davemuscle/camera_journey/doc/calling_the_gen.png

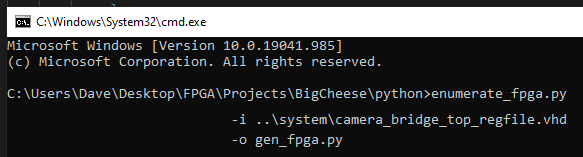
doc/calling_the_gen.png
