davemuscle/camera_journey/doc/CameraJourneyFront.jpg

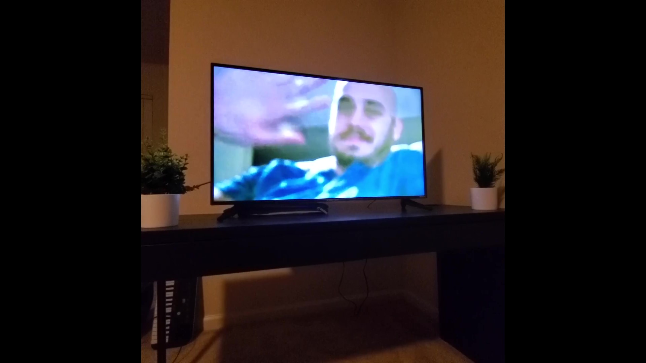
doc/CameraJourneyFront.jpg
