davemuscle/camera_journey/doc/device_tree.png

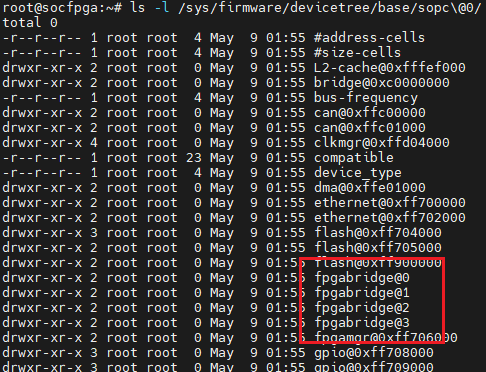
doc/device_tree.png
