davemuscle/camera_journey/doc/putty_boot.png

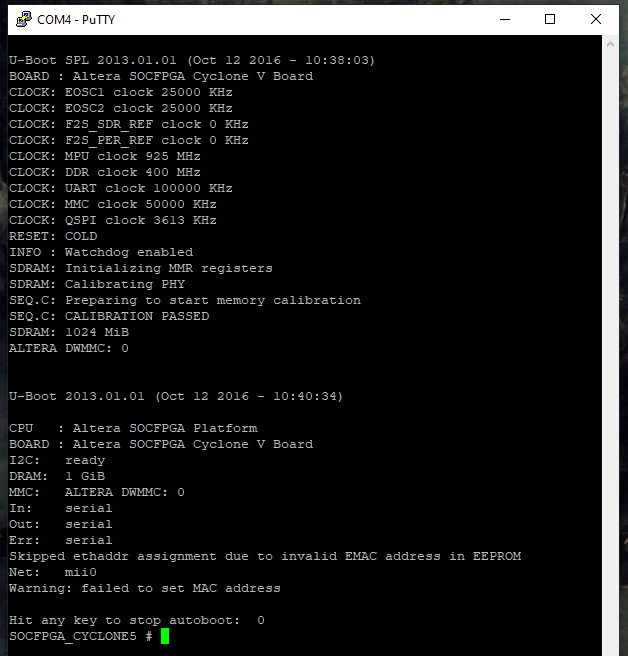
doc/putty_boot.png
