davemuscle/camera_journey/matlab/Font/CourierNew36_FontMap_MonoChrome.bmp

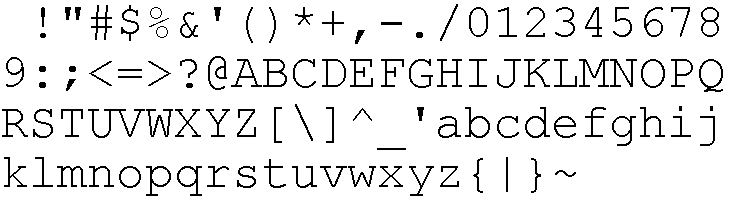
matlab/Font/CourierNew36_FontMap_MonoChrome.bmp
