davemuscle/camera_journey/kicad/DualCameraPlugIn.kicad_pcb

## KiCad design kicad/DualCameraPlugIn.kicad_pcb (2022-02-21)

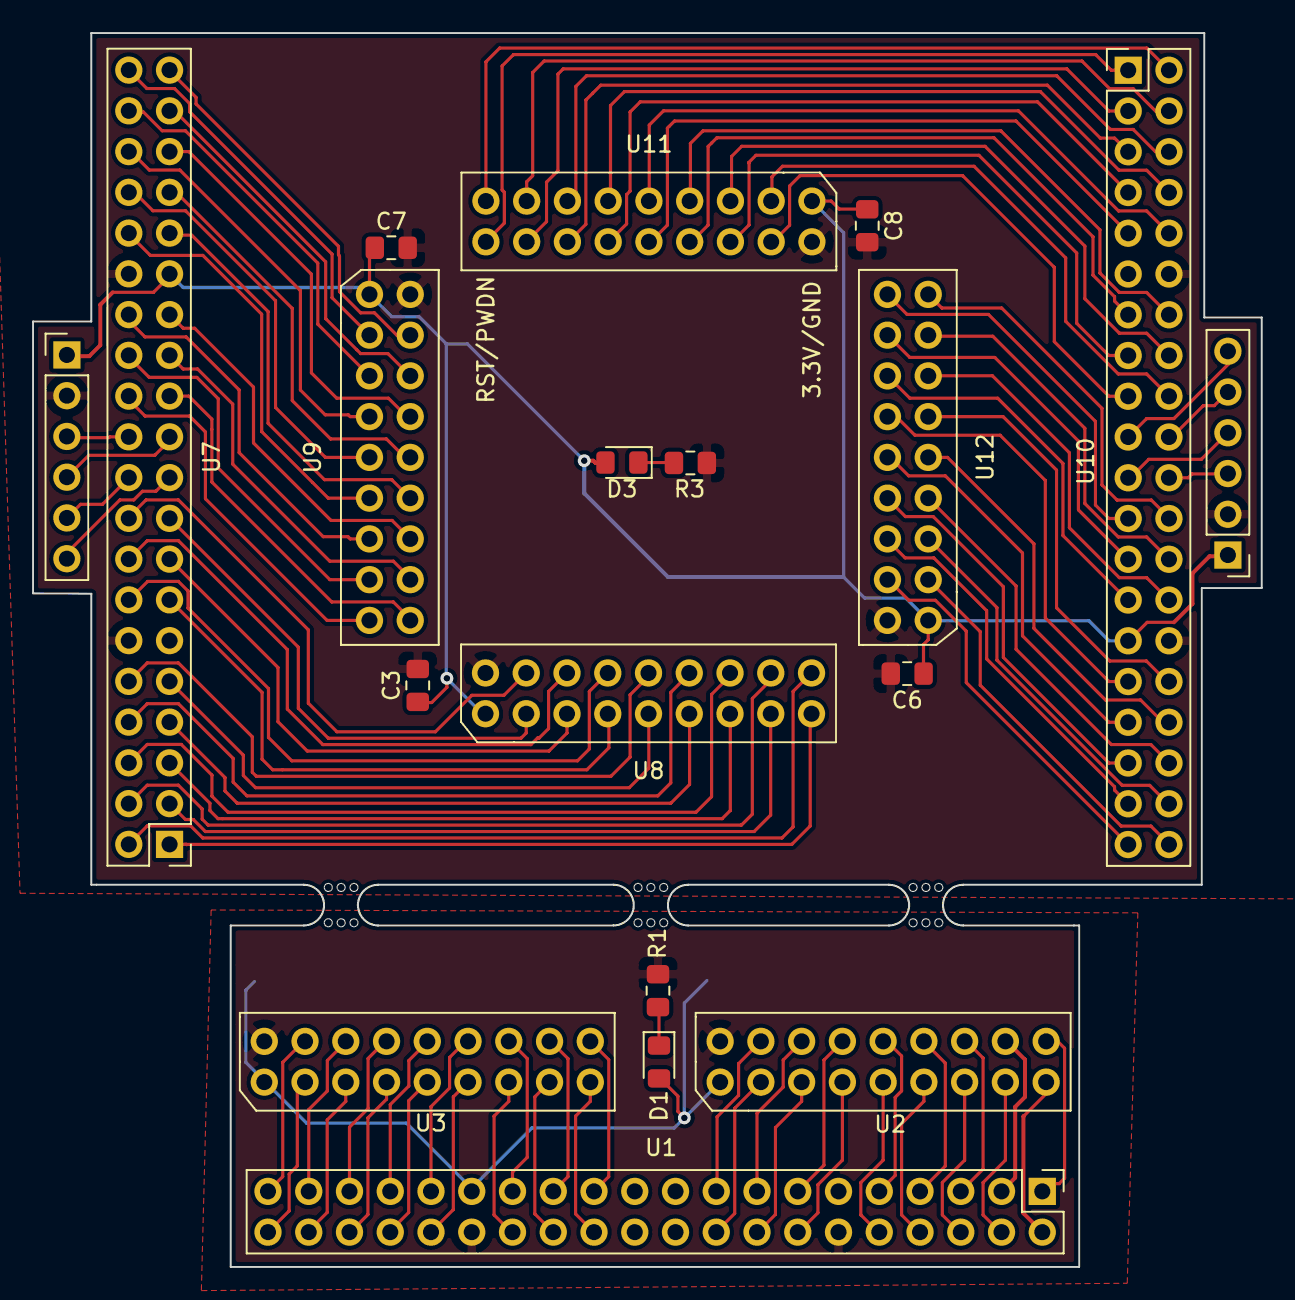
[picture p40: board DualCameraPlugIn.kicad_pcb from above]

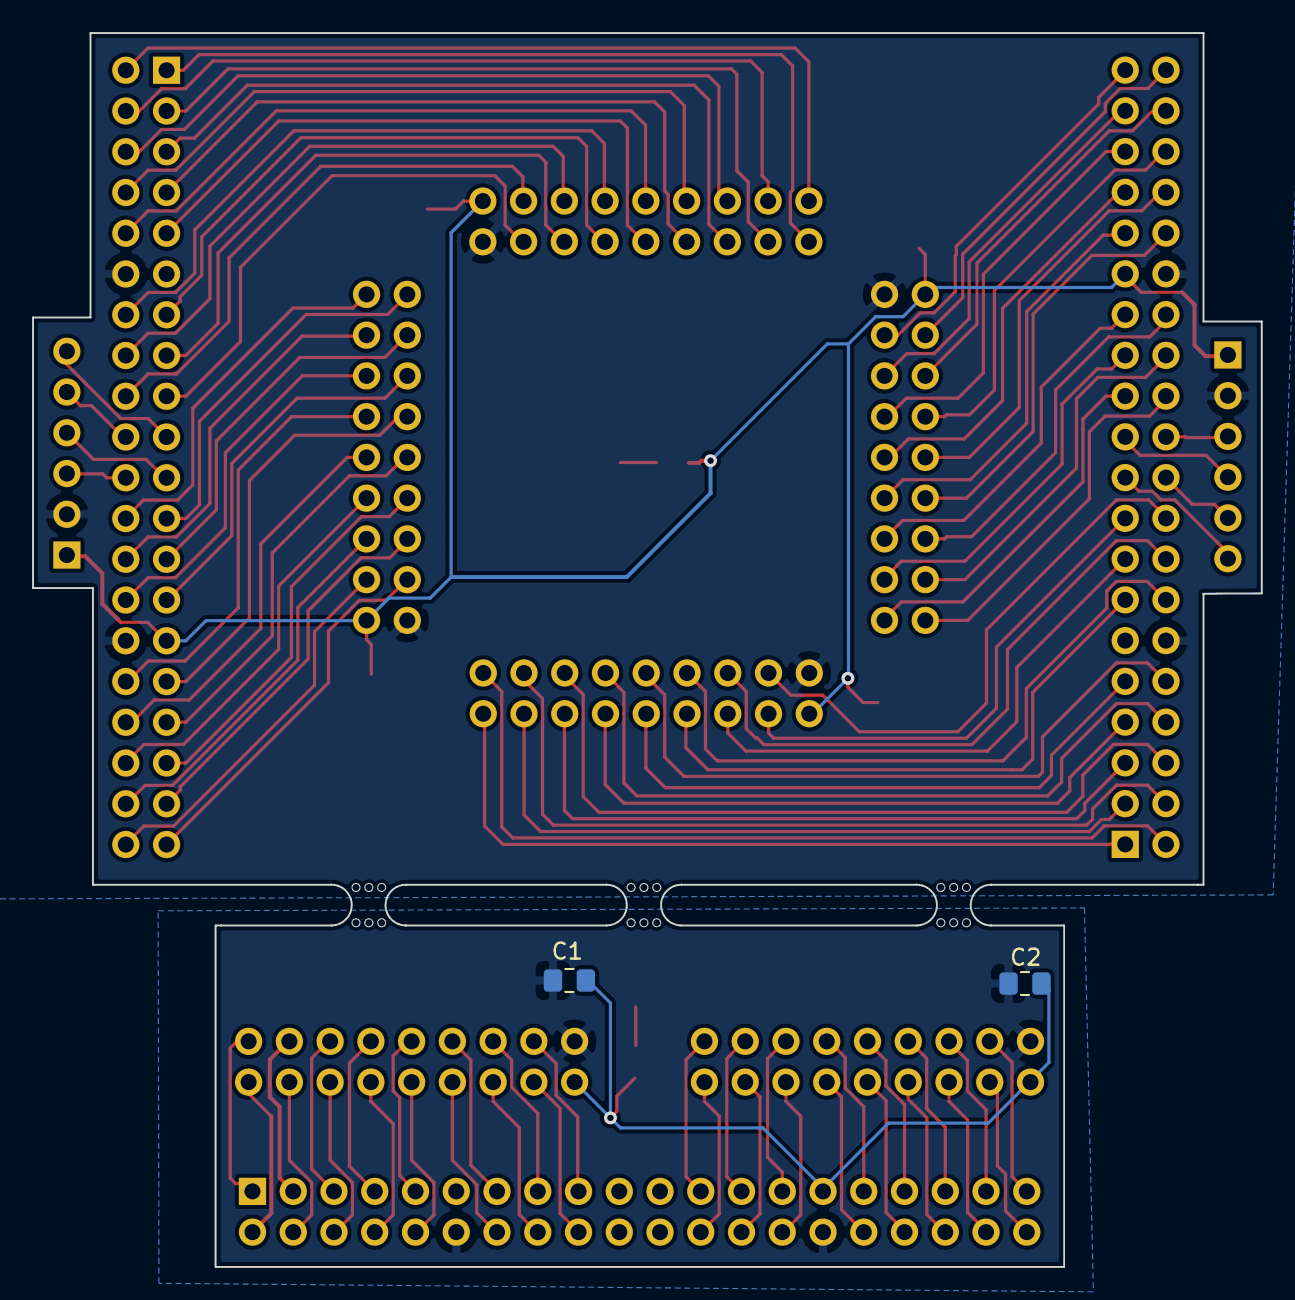
[picture p41: board DualCameraPlugIn.kicad_pcb from below]

Board: 2 copper layers, 76.6 x 76.9 mm, 24 parts (2 on the bottom side), 110 nets.

Parts:
C1, C2, C3, C6, C7, C8: 0.1u; C_0805_2012Metric_Pad1.15x1.40mm_HandSolder
D1, D3: LED; LED_0805_2012Metric_Pad1.15x1.40mm_HandSolder
J1, J2: Conn_01x06; PinHeader_1x06_P2.54mm_Vertical
R1, R3: R; R_0805_2012Metric_Pad1.15x1.40mm_HandSolder
U1, U7: DE10-Nano-GPIO1; PinHeader_2x20_P2.54mm_Vertical
U2, U3, U8, U9, U11, U12: Waveshare_OV5640_DVP; WaveshareOV5640
U10: DE10-Nano-GPIO0; PinHeader_2x20_P2.54mm_Vertical
mouse-bite-2.54mm-slot, mouse-bite-2.54mm-slot#2, mouse-bite-2.54mm-slot#3: VAL**; mouse-bite-2.54mm-slot

Connections:
+3V3: C3.1, C6.1, C7.1, C8.1, D3.2, J1.1, J2.1, U7.29, U8.1, U9.1, U10.29, U11.1, U12.1
+3V3_CAM1: C1.1, C2.1, D1.2, U1.29, U2.1, U3.1
/DualCamera/CAM1_A_D2: U1.3, U2.16
/DualCamera/CAM1_A_D3: U1.4, U2.15
/DualCamera/CAM1_A_D4: U1.5, U2.14
/DualCamera/CAM1_A_D5: U1.6, U2.13
/DualCamera/CAM1_A_D6: U1.7, U2.12
/DualCamera/CAM1_A_D7: U1.8, U2.11
/DualCamera/CAM1_A_D8: U1.9, U2.10
/DualCamera/CAM1_A_D9: U1.10, U2.9
/DualCamera/CAM1_A_HREF: U1.15, U2.6
/DualCamera/CAM1_A_PCLK: U1.14, U2.7
/DualCamera/CAM1_A_PWDN: U1.1, U2.18
/DualCamera/CAM1_A_RESET: U1.2, U2.17
/DualCamera/CAM1_A_SIOC: U1.18, U2.3
/DualCamera/CAM1_A_SIOD: U1.17, U2.4
/DualCamera/CAM1_A_VSYNC: U1.16, U2.5
/DualCamera/CAM1_A_XCLK: U1.13, U2.8
/DualCamera/CAM1_B_D2: U1.25, U3.16
/DualCamera/CAM1_B_D3: U1.26, U3.15
/DualCamera/CAM1_B_D4: U1.27, U3.14
/DualCamera/CAM1_B_D5: U1.28, U3.13
/DualCamera/CAM1_B_D6: U1.31, U3.12
/DualCamera/CAM1_B_D7: U1.32, U3.11
/DualCamera/CAM1_B_D8: U1.33, U3.10
/DualCamera/CAM1_B_D9: U1.34, U3.9
/DualCamera/CAM1_B_HREF: U1.37, U3.6
/DualCamera/CAM1_B_PCLK: U1.36, U3.7
/DualCamera/CAM1_B_PWDN: U1.23, U3.18
/DualCamera/CAM1_B_RESET: U1.24, U3.17
/DualCamera/CAM1_B_SIOC: U1.40, U3.3
/DualCamera/CAM1_B_SIOD: U1.39, U3.4
/DualCamera/CAM1_B_VSYNC: U1.38, U3.5
/DualCamera/CAM1_B_XCLK: U1.35, U3.8
/QuadCamera/CAM0_A_D2: U10.3, U11.16
/QuadCamera/CAM0_A_D3: U10.4, U11.15
/QuadCamera/CAM0_A_D4: U10.5, U11.14
/QuadCamera/CAM0_A_D5: U10.6, U11.13
/QuadCamera/CAM0_A_D6: U10.7, U11.12
/QuadCamera/CAM0_A_D7: U10.8, U11.11
/QuadCamera/CAM0_A_D8: U10.9, U11.10
/QuadCamera/CAM0_A_D9: U10.10, U11.9
/QuadCamera/CAM0_A_HREF: U10.15, U11.6
/QuadCamera/CAM0_A_PCLK: U10.14, U11.7
/QuadCamera/CAM0_A_PWDN: U10.1, U11.18
/QuadCamera/CAM0_A_RESET: U10.2, U11.17
/QuadCamera/CAM0_A_SIOC: U10.18, U11.3
/QuadCamera/CAM0_A_SIOD: U10.17, U11.4
/QuadCamera/CAM0_A_VSYNC: U10.16, U11.5
/QuadCamera/CAM0_A_XCLK: U10.13, U11.8
/QuadCamera/CAM0_B_D2: U10.25, U12.16
/QuadCamera/CAM0_B_D3: U10.26, U12.15
/QuadCamera/CAM0_B_D4: U10.27, U12.14
/QuadCamera/CAM0_B_D5: U10.28, U12.13
/QuadCamera/CAM0_B_D6: U10.31, U12.12
/QuadCamera/CAM0_B_D7: U10.32, U12.11
/QuadCamera/CAM0_B_D8: U10.33, U12.10
/QuadCamera/CAM0_B_D9: U10.34, U12.9
/QuadCamera/CAM0_B_HREF: U10.37, U12.6
/QuadCamera/CAM0_B_PCLK: U10.36, U12.7
/QuadCamera/CAM0_B_PWDN: U10.23, U12.18
/QuadCamera/CAM0_B_RESET: U10.24, U12.17
/QuadCamera/CAM0_B_SIOC: U10.40, U12.3
/QuadCamera/CAM0_B_SIOD: U10.39, U12.4
/QuadCamera/CAM0_B_VSYNC: U10.38, U12.5
/QuadCamera/CAM0_B_XCLK: U10.35, U12.8
/QuadCamera/CAM1_A_D2: U7.4, U8.16
/QuadCamera/CAM1_A_D3: U7.3, U8.15
/QuadCamera/CAM1_A_D4: U7.6, U8.14
/QuadCamera/CAM1_A_D5: U7.5, U8.13
/QuadCamera/CAM1_A_D6: U7.8, U8.12
/QuadCamera/CAM1_A_D7: U7.7, U8.11
/QuadCamera/CAM1_A_D8: U7.10, U8.10
/QuadCamera/CAM1_A_D9: U7.9, U8.9
/QuadCamera/CAM1_A_HREF: U7.16, U8.6
/QuadCamera/CAM1_A_PCLK: U7.13, U8.7
/QuadCamera/CAM1_A_PWDN: U7.2, U8.18
/QuadCamera/CAM1_A_RESET: U7.1, U8.17
/QuadCamera/CAM1_A_SIOC: U7.17, U8.3
/QuadCamera/CAM1_A_SIOD: U7.18, U8.4
/QuadCamera/CAM1_A_VSYNC: U7.15, U8.5
/QuadCamera/CAM1_A_XCLK: U7.14, U8.8
/QuadCamera/CAM1_B_D2: U7.25, U9.16
/QuadCamera/CAM1_B_D3: U7.26, U9.15
/QuadCamera/CAM1_B_D4: U7.27, U9.14
/QuadCamera/CAM1_B_D5: U7.28, U9.13
/QuadCamera/CAM1_B_D6: U7.31, U9.12
/QuadCamera/CAM1_B_D7: U7.32, U9.11
/QuadCamera/CAM1_B_D8: U7.33, U9.10
/QuadCamera/CAM1_B_D9: U7.34, U9.9
/QuadCamera/CAM1_B_HREF: U7.37, U9.6
/QuadCamera/CAM1_B_PCLK: U7.36, U9.7
/QuadCamera/CAM1_B_PWDN: U7.23, U9.18
/QuadCamera/CAM1_B_RESET: U7.24, U9.17
/QuadCamera/CAM1_B_SIOC: U7.40, U9.3
/QuadCamera/CAM1_B_SIOD: U7.39, U9.4
/QuadCamera/CAM1_B_VSYNC: U7.38, U9.5
/QuadCamera/CAM1_B_XCLK: U7.35, U9.8
/QuadCamera/EX1: J2.3, U7.22
/QuadCamera/EX2: J2.4, U7.21
/QuadCamera/EX3: J2.5, U7.20
/QuadCamera/EX4: J2.6, U7.19
/QuadCamera/EX5: J1.3, U10.22
/QuadCamera/EX6: J1.4, U10.21
/QuadCamera/EX7: J1.5, U10.20
/QuadCamera/EX8: J1.6, U10.19
GND: C3.2, C6.2, C7.2, C8.2, J1.2, J2.2, R3.2, U7.12, U7.30, U8.2, U9.2, U10.12, U10.30, U11.2, U12.2
GND_CAM1: C1.2, C2.2, R1.2, U1.12, U1.30, U2.2, U3.2
unnamed: D1.1, R1.1
unnamed: D3.1, R3.1
