davemuscle/camera_journey/python/enumerate_fpga.py

import os
import sys
import getopt
import re

REG_PARSE_STR_KEY = "@REG@"
REG_PARSE_DNE_KEY = "@DNE@"

args, vals = getopt.getopt(sys.argv[1:],"i:o:")

ifilepath = ""
ofilepath = ""

for arg,val in args:
    if(arg == "-i"):
        ifilepath = val
    elif(arg == "-o"):
        ofilepath = val

#Register Hash Key Structure:
#Address -> Designator (optional), Register Name, 
#           Bitfield Names, BitField Positons, BitField Descriptions (all arrays)
class register_class:
    designator         = ""
    name               = ""
    access             = ""
    bitfields          = [""]
    bitpositions_upper = [0]
    bitpositions_lower = [0]
    bitdescriptions    = [""]
    
regmap={}

fr = open(ifilepath, "r")

lines = fr.readlines()

#Filter only for comments, strip left and right whitespace
lines_temp = []
for line in lines:
    r = re.search("--",line)
    if(r):
        line = line.strip()
        line = line + "\r\n"
        line = line.replace("--","")
        lines_temp.append(line)
    else:
        continue
lines = lines_temp
print("--------------------------------------------------------")
print("--------------------------------------------------------")
print("--------------------------------------------------------")
#Filter between the start keys and the done keys
active = 0
type = 1
lines_temp = []
lines_num = []
for line in lines:
    #Default to assuming the line is a bitfield position
    type = 2
        
    #Check if the line matches with the start of a register description
    r = re.search(REG_PARSE_STR_KEY,line)
    if(r):
        print("Found register: " + line.rstrip())
        active = 1
        type = 0
        
    r = re.search(REG_PARSE_DNE_KEY,line)
    if(r):
        print("Found done")
        active = 0
        type = 3

        
    r = re.search("\@\[.*\]",line)
    if(r):
        print("Found Bitfield")
        type = 1
        
    if(active == 1):
        print("Appending line: " + line.rstrip())
        lines_temp.append(line)
        lines_num.append(type)
    elif(active == 0 and type == 3):
        print("Inserting dummy done marker")
        lines_temp.append("")
        lines_num.append(type)
    else:
        print("Removing line: " + line.rstrip())
    
lines = lines_temp;

print("--------------------------------------------------------")
print("--------------------------------------------------------")
print("--------------------------------------------------------")
for i in range(0, len(lines)):
    print(str(lines_num[i])+"\t"+lines[i].strip())

print("--------------------------------------------------------")
print("--------------------------------------------------------")
print("--------------------------------------------------------")
bitfields          = [""]
bitpositions_upper = [0]
bitpositions_lower = [0]
bitdescriptions    = [""]
bitnum             = 0
#Go through the filtered list and pick out the information to add to the hash table
for i in range(0,len(lines)):
    line = lines[i]
    type = lines_num[i]
    if(type == 0):
        #Start of register description
        r = re.findall('\[(.*?)\]',line)
        #Should capture 4 groups
        if(len(r) != 4):
            print("Weird parse for initial register line comment")
            exit()
        designator          = r[0].replace(REG_PARSE_STR_KEY,"").strip()
        address             = r[1].strip()
        name                = r[2].strip()
        access              = r[3].strip()
        print("Register Parsed, found these details:")
        print("\t"+designator)
        print("\t"+address)
        print("\t"+name)
        print("\t"+access)
        
    elif(type == 1):
        #Start of bitfield - name and position
        r = re.findall('(\[.*?\])',line)
        if(len(r) != 1):
            print("Weird parse for initial bitfield name")
            exit()
        #Get position
        upper = 0 
        lower = 0
        r = re.search('\[\d+:\d+]',line)
        if(r):
            #Multi-bit field
            r = re.search('\[(\d+):(\d+)\]',line)
            upper = r.group(1)
            lower = r.group(2)
        else:
            #Single-bit field
            r = re.search('\[(.*?)\]',line)
            upper = r.group(1)
            lower = r.group(1)
        #Get name
        bname = ""
        r = re.search('\](.*)',line)
        if(r):
            bname = r.group(1)
            bname = bname.strip()
        else:
            print("Weird parse for initial bitfield name")
            exit()
        print("Bitfield Parsed, found these details:")
        print("\t"+bname)
        print("\t"+upper)
        print("\t"+lower)
        
        if(int(upper) > 31):
            print("Bad upper bound: " + str(upper))
            exit()
        if(int(lower) < 0):
            print("Bad lower bound: " + str(lower))
            exit()
        if(int(lower) > int(upper)):
            print("Bad lower or upper bound: " + str(lower) + " > " + str(upper))
            exit()
            
        bitnum = bitnum + 1
        
        bitfields.append(bname)
        bitpositions_upper.append(upper)
        bitpositions_lower.append(lower)
        bitdescriptions.append("")
        
        
    elif(type == 2):
        bitdescriptions[bitnum] = bitdescriptions[bitnum] + line.strip() + "\r\n"
    elif(type == 3):
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
